SuperDabT/stm32-lidar-scanner/captures/width_test.txt

48,111,313,49,1
46,111,322,49,1
44,111,336,49,1
42,111,345,49,1
40,111,346,49,1
38,111,331,49,1
36,111,325,49,1
34,111,302,49,1
32,111,276,49,1
30,111,270,49,1
28,111,264,49,1
26,111,260,49,1
24,111,254,49,1
22,111,251,49,1
20,111,248,49,1
18,111,245,49,1
16,111,243,49,1
14,111,237,49,1
12,111,232,49,1
10,111,261,49,1
8,111,266,49,1
6,111,259,49,1
4,111,264,49,1
2,111,264,49,1
DET,109,15
0,111,262,49,1
2,111,257,49,1
4,111,263,49,1
6,111,264,49,1
8,111,260,49,1
10,111,261,49,1
12,111,267,49,1
14,111,257,49,1
16,111,234,49,1
18,111,248,49,1
20,111,244,49,1
22,111,246,49,1
24,111,250,49,1
26,111,253,49,1
28,111,258,49,1
30,111,261,49,1
32,111,268,49,1
34,111,275,49,1
36,111,288,49,1
38,111,320,49,1
40,111,331,49,1
42,111,342,49,1
44,111,345,49,1
46,111,340,49,1
48,111,325,49,1
50,111,316,49,1
52,111,307,49,1
54,111,298,49,1
56,111,290,49,1
58,111,285,49,1
60,111,279,49,1
62,111,274,49,1
64,111,268,49,1
66,111,263,49,1
68,111,257,49,1
70,111,254,49,1
72,111,250,49,1
74,111,249,49,1
76,111,244,49,1
78,111,242,49,1
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
DET,23,173,32
0,111,263,49,1
2,111,257,49,1
4,111,264,49,1
6,111,264,49,1
8,111,260,49,1
10,111,262,49,1
12,111,268,49,1
14,111,254,49,1
16,111,235,49,1
18,111,240,49,1
20,111,175,49,1
22,111,173,49,1
24,111,173,49,1
26,111,172,49,1
28,111,178,49,1
30,111,182,49,1
32,111,258,49,1
34,111,274,49,1
36,111,293,49,1
38,111,324,49,1
40,111,330,49,1
42,111,343,49,1
44,111,345,49,1
46,111,337,49,1
48,111,326,49,1
50,111,316,49,1
52,111,305,49,1
54,111,297,49,1
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
122,111,242,49,1
120,111,246,49,1
118,111,34,49,1
116,111,30,49,1
114,111,27,49,1
112,111,22,49,1
110,111,20,49,1
108,111,21,49,1
106,111,21,49,1
104,111,22,49,1
102,111,24,49,1
100,111,30,49,1
98,111,230,49,1
96,111,230,49,1
94,111,229,49,1
92,111,121,49,1
90,111,115,49,1
88,111,115,49,1
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
