SuperDabT/stm32-lidar-scanner/Core/Src/main.c

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
/* Includes ------------------------------------------------------------------*/
#include "main.h"
#include "detect.h"
#include "stm32f4xx_hal.h"
#include "tim.h"
#include "usart.h"
#include "gpio.h"

/* USER CODE BEGIN Includes */
#include <stdint.h>
#include <stdio.h>
#include <stdbool.h>
#include "servo.h"
#include "tfluna.h"
#include "detect.h"
/* USER CODE END Includes */

/* USER CODE BEGIN PD */
#define SCAN_DWELL_MS      50      // Servo settle time before next reading
#define TEMP_TRIP_C        60.0f   // Halt scanning at or above this
#define TEMP_CLEAR_C       55.0f   // Resume scanning at or below this
#define WARN_INTERVAL_MS   1000    // How often to print the halt warning
#define SCAN_TILT 0   /* 1 = tilt raster on, 0 = level-only scanning */


/* USER CODE END PD */


void SystemClock_Config(void);
/* USER CODE BEGIN PFP */
bool elapsed(uint32_t *last, uint32_t interval);
int _write(int file,char *ptr, int len);
/* USER CODE END PFP */

/**
  * @brief  The application entry point.
  * @retval int
  */
int main(void)
{

  /* MCU Configuration--------------------------------------------------------*/

  /* Reset of all peripherals, Initializes the Flash interface and the Systick. */
  HAL_Init();

  /* Configure the system clock */
  SystemClock_Config();

  /* Initialize all configured peripherals */
  MX_GPIO_Init();
  MX_TIM2_Init();
  MX_USART2_UART_Init();
  MX_USART1_UART_Init();
  /* USER CODE BEGIN 2 */
servo_init();
tfluna_init();




/* USER CODE END 2 */

  /* Infinite loop */
  /* USER CODE BEGIN WHILE */
		while (1) {

    /* Static so they survive between iterations. The loop body runs
       thousands of times a second; the timed block inside is what actually
       steps the scan. */
    
    static bool halted=false;
    static float    pan_angle     = 0.0f;
    static float    pan_step      = PAN_STEP_DEG;
    static uint32_t pan_last_move = 0;
    static uint32_t warn_last=0;

    static float tilt_angle = TILT_LEVEL;
    #if SCAN_TILT
    static float tilt_step  = TILT_STEP_DEG;
    #endif

    bool reversed = false;


    /* 50 ms is measured, not chosen. A servo commanded to a new angle is
       still travelling when the next reading arrives, so the reading
       belongs to a position the code has already left. The error shows up
       as a sharp edge landing at different bearings depending on sweep
       direction: 40 ms gives 6 degrees of split, 45 gives 4, 50 gives 2,
       65 gives none. 50 is the fastest interval holding the split within
       one 2-degree step, which is the floor either way. */
    
    /* Two thresholds, not one. The TF-Luna's ceiling is 60 C and it runs
         43-52 in normal operation, so a single threshold would flap on and
         off at the boundary. Trips at 60, clears at 55; between the two it
         holds whatever state it's in. */

    
    if (elapsed(&pan_last_move, SCAN_DWELL_MS)) {
      float temp_c=tfluna_temperature();
      if(temp_c>=TEMP_TRIP_C){
        halted=true;
    }
    if(temp_c<=TEMP_CLEAR_C){
      halted=false;
    }
    
    if (halted){
      if (elapsed(&warn_last, WARN_INTERVAL_MS)){
      printf("WARNING: TF-Luna at %d C, SCANNING HALTED\r\n",
      (int)temp_c);
    }
  }
    else{

        tfluna_reading_t current_reading= tfluna_read();

      
      uint16_t distance=current_reading.distance;
      bool valid=current_reading.valid;
      

        /* Report before commanding. At this point pan_angle is still the
           angle the head has been parked at for the last 50 ms, so the
           reading and the label match. Printing after the move would
           attach each reading to the position it was heading toward
           rather than the one it came from. */
        printf("%d,%d,%d,%d,%d\r\n",
          (int)pan_angle,
          (int)tilt_angle,
          distance,
          (int)temp_c,
          valid);



        if (valid) {
          uint16_t  true_bearing=pan_angle;

        if(pan_step<0){
          true_bearing=pan_angle+PAN_DOWN_CORR_DEG; 
        }

          
          bool run_closed=detect_feed((int)true_bearing, distance,HAL_GetTick());

          if (run_closed) {
            detection_t newest_detection = detect_latest();
            if (newest_detection.found) {
              printf("DET,%d,%d,%u\r\n", (int)newest_detection.bearing,
                     newest_detection.distance, newest_detection.width);
            }
          }
        }
        pan_angle += pan_step;
        servo_write(pan_angle, 'p');

        /* Limit test after the command, so the angle written is always the
           limit itself and never one step past it. */
        if (pan_angle >= PAN_MAX) {
            pan_step = -pan_step;
            reversed = true;
        }
        if (pan_angle <= PAN_MIN) {
            pan_step = -pan_step;
            reversed = true;
        }

        /* Tilt advances once per completed pan sweep, giving stacked
           horizontal rows rather than the diagonal smear you get from
           stepping both axes together. Step stays at 3 degrees: the beam
           is about 2 wide, so a larger step would leave unscanned gaps
           between rows. */
           #if SCAN_TILT
        if (reversed) {
          servo_write(tilt_angle, 't');

          tilt_angle += tilt_step;
          if (tilt_angle >= SCAN_TILT_MAX) {
            tilt_angle = SCAN_TILT_MAX;
            tilt_step = -tilt_step;
          }
          if (tilt_angle <= SCAN_TILT_MIN) {
            tilt_angle = SCAN_TILT_MIN;
            tilt_step = -tilt_step;
          }
        }
        #endif
        if(reversed){
          detect_sweep_end();
          detection_t detections[MAX_OBJECTS];
          uint8_t sus_objects;

          sus_objects=detect_result(detections, MAX_OBJECTS);

          for(uint8_t i=0;i<sus_objects;i++){
            printf("DET,%d,%d,%u\r\n",
            (int)detections[i].bearing,
            detections[i].distance,
            detections[i].width);
          }
        }
    }
  }
	}


            
  

    /* USER CODE END WHILE */
    
}


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
/* USER CODE BEGIN 4 */

/* Non-blocking interval timer. Takes a pointer so each caller keeps its own
   schedule in the same loop — no blocking delays anywhere in normal
   operation. Everything stays uint32_t deliberately: HAL_GetTick wraps
   after about 49 days, and unsigned subtraction wraps with it, so the
   elapsed time stays correct across the rollover. Storing the result in a
   signed type would make the comparison fail permanently. */

bool elapsed(uint32_t *last, uint32_t interval) {
  uint32_t now_ms=HAL_GetTick();
	if (now_ms - *last >= interval) {
		*last = now_ms;
		return true;
	} else
		return false;
}

/* printf retarget. newlib calls _write for stdout, so this puts printf on
   USART2 and the ST-Link virtual COM port. Blocking: a 20-character CSV
   line is about 1.7 ms at 115200, which sits inside the 50 ms budget but
   is real time spent, and it grows if fields are added. */

int _write(int file,char *ptr, int len){
	HAL_UART_Transmit(&huart2,(uint8_t *)ptr,len,5);
	return len;
}
/* USER CODE END 4 */
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
