SuperDabT/stm32-lidar-scanner/Core/Src/detect.c

/* detect.c — finds things in the room that weren't there when it was empty.

   Two phases:
   1. CALIBRATING: the room is empty. Record 3 sweeps, take the middle
      value at each angle. That's the "before photo" (baseline).
   2. WATCHING: compare every new reading to the before photo. A run of
      readings that are much closer than normal is a candidate object.

   Detection only finds candidates. It has no memory between sweeps, so
   it can't tell a person from a moved chair; the tracker decides that. */

#include "detect.h"
#include "servo.h"
#include <stdbool.h>
#include <stdint.h>
#include <math.h>

/* ---- Settings ---------------------------------------------------------- */

/* One slot per angle the head stops at: 0, 2, 4 ... so (range / step) + 1.
   Tied to the servo constants, so changing the step resizes everything. */
#define PAN_SLOTS ((((int)PAN_MAX - (int)PAN_MIN) / (int)PAN_STEP_DEG) + 1)

/* Sweeps recorded during calibration. Must be odd: the median of an even
   count averages the middle two, so one bad reading blends in instead of
   being outvoted. 3 is the smallest count that protects you. */
#define BASELINE_SWEEPS 3

/* How much closer than normal a reading must be to count as "something
   there". Measured: below 15 the sensor's own wobble trips it, above 65
   a person gets missed. 40 is the middle of that band. */
#define MIN_DROP_CM 40

/* Fewest readings in a row before a run is believed. Shorter = glitch. */
#define MIN_RUN_LENGTH 3

/* ---- Calibration memory ------------------------------------------------ */

static uint16_t background[PAN_SLOTS][BASELINE_SWEEPS]; /* scratch pad: 3 raw readings per angle */
static uint16_t baseline[PAN_SLOTS];                    /* finished before photo: 1 per angle */
static uint8_t  sweep_counter = 0;                      /* which calibration column we're filling */
static bool     calibrating   = true;                   /* start by learning the room */

/* ---- The run currently being built --------------------------------------
   Instead of storing every reading in a run, keep just what we need:
   where it started, where it ended, the closest point, and how long.   */

static uint16_t first_bearing;
static uint16_t first_dist;
static uint16_t last_bearing;
static uint16_t last_dist;
static uint16_t min_dist;            /* closest point: ignores the half-on-the-wall edges */
static uint8_t  readings_count = 0;  /* 0 means no run is going */
static uint32_t first_time;
static uint32_t last_time;

/* ---- Finished runs, waiting for main.c to collect them ------------------ */

static detection_t objects[MAX_OBJECTS];
static uint8_t     object_count    = 0;  /* how many stored = index of next free slot */
static uint16_t    dropped_counter = 0;  /* runs lost because all slots were full */

/* ---- Helpers ------------------------------------------------------------ */



/* Middle value of three. Sorts them by swapping, then b is the middle. */
static uint16_t median3(uint16_t a, uint16_t b, uint16_t c) {
  uint16_t temp_val = 0;

  if (a > b) { temp_val = a; a = b; b = temp_val; }
  if (a > c) { temp_val = c; c = a; a = temp_val; }
  if (b > c) { temp_val = c; c = b; b = temp_val; }
  return b;
}




to_xy_t convert_xy (float bearing,uint16_t distance){
  to_xy_t point;

  point.x= distance*cosf((bearing*((float)M_PI/180)));
  point.y= distance*sinf((bearing*((float)M_PI/180)));

  return point;
}

detection_t detect_latest(void){
  if(object_count==0){
    detection_t temporary;
    temporary.found=false;
    return temporary;
  }
  return objects[object_count-1];
}

static bool close_run(void) {
  bool saved=false;
  if (readings_count >= MIN_RUN_LENGTH) {       /* real, not a glitch */
    if (object_count < MAX_OBJECTS) { 
      
      to_xy_t first_point=convert_xy(first_bearing,first_dist);
      to_xy_t last_point=convert_xy(last_bearing,last_dist);        
      
      float dx=last_point.x-first_point.x;
      float dy=last_point.y-first_point.y;

      /* room on the shelf */
      objects[object_count].found    = true;
      objects[object_count].distance = min_dist;
      objects[object_count].width    = (uint16_t)sqrtf((dx*dx)+(dy*dy));      
      objects[object_count].bearing  = (last_bearing + first_bearing) / 2.0f; /* middle */
      objects[object_count].time_stamp_ms=first_time + (last_time-first_time)/2;
      object_count++;
      saved=true;
    } else {
      dropped_counter++;                       /* shelf full, count the loss */
    }
  }
  readings_count = 0;  
  return saved;                         /* no run going anymore */
}



/* ---- Public functions (declared in detect.h) --------------------------- */

/* Start (or restart) learning the room. Room must be empty.
   Call only with the head at PAN_MIN, about to begin a sweep: if
   calibration starts mid-sweep, the first column misses some angles,
   their median comes out 0, and those angles go permanently blind. */
void detect_calibrate(void) {
  sweep_counter = 0;
  calibrating = true;
  object_count=0;
  readings_count=0;
}

/* Called by main.c once per reading, every 50 ms. */
bool detect_feed(uint16_t bearing, uint16_t distance,uint32_t time_ms) {
  /* Turn the angle into a shelf slot: 0 → 0, 2 → 1, 4 → 2 ... */
  uint16_t slot = (uint16_t)((bearing - PAN_MIN) / PAN_STEP_DEG);
  if (slot >= PAN_SLOTS) {
    return false;                                     /* off the end: reject, don't corrupt memory */
  }

  if (calibrating) {
    /* Learning: write this reading into the current sweep's column. */
    if (sweep_counter >= BASELINE_SWEEPS) {
      return false;
    }
    background[slot][sweep_counter] = distance;

  } else {
    /* Watching: is this reading a lot closer than the empty room?
       (Written as "distance + 40 < baseline" rather than "distance 
       baseline - 40", because both are unsigned: a baseline under 40
       would wrap around to a huge number.) */
    if (distance + MIN_DROP_CM < baseline[slot]) {
      /* Close: the run grows. */
      if (readings_count == 0) {                /* first reading of a new run */
        first_bearing = bearing;
        first_dist    = distance;
        min_dist      = distance;
        first_time    =time_ms;
      }
      last_bearing = bearing;                   /* always the most recent */
      last_dist    = distance;
      last_time    =time_ms;
      if (distance < min_dist) {
        min_dist = distance;                    /* keep the closest */
      }
      readings_count++;

    } else {
      /* Not close: whatever run was going just ended. */
      bool valid= close_run();
      return valid;
    }
  }
  return false;
}

/* Called by main.c when the head turns around at either end. */
void detect_sweep_end(void) {
  if (calibrating) {
    /* One more column filled. After the last one, squash each angle's
       three readings into one number and switch to watching. */
    sweep_counter++;
    if (sweep_counter == BASELINE_SWEEPS) {
      for (uint8_t i = 0; i < PAN_SLOTS; i++) {
        baseline[i] = median3(background[i][0], background[i][1], background[i][2]);
      }
      calibrating = false;
    }
  }
  close_run();
}

uint8_t detect_result(detection_t detection_array[], uint8_t max_slots){
  uint8_t to_copy;

  to_copy=object_count;
  if(to_copy>max_slots){ to_copy=max_slots;}

  for(uint8_t i=0;i<to_copy;i++){
    detection_array[i]=objects[i];
  }
  object_count=0;

  return to_copy;
}
