SuperDabT/stm32-lidar-scanner/(commit log)

2026-09-06 added a new function servo_home() for smoother startup
2026-09-06 Split the servo code into servo.c/ servo.h
2026-09-06 TF-Luna driver: interrupt-driven UART, frame parser, distance/validity/temperature accessors
2026-09-07 Update README with photos and current project state
2026-09-07 Guard against garbled serial lines in scanner_plot.py
    A UART glitch that corrupts a field's digits (right field count, bad
    content) previously raised an unhandled ValueError and crashed the
    whole live plot. Now that line is just skipped.
    [scanner_plot.py]
2026-09-07 Fix UART error recovery, mark ISR state volatile, improve plotter
    [scanner_plot.py, tfluna.c]
2026-09-08 Extend scanner_plot.py radial range to 400
    Readings past 300 were landing outside the plotted disc and getting
    clipped. Widening the radial axis so the longer returns stay visible.
    Claude-Session: https://claude.ai/code/session_012mnMaa157uQ9seyVkrUntT
2026-09-10 Remove ST-specific compiler flag, drop leaf HAL include
    -fcyclomatic-complexity is not recognised by stock arm-none-eabi-gcc,
    which broke the build on Linux. Also removed the direct
    stm32f4xx_hal_uart.h include from tfluna.c; main.h already pulls it in.
    [tfluna.c]
2026-09-10 Name servo timing constants, document pan range headroom
    Replace magic numbers in servo_write with SERVO_MIN_US, SERVO_MAX_US
    and SERVO_RANGE_DEG, separating the servo's fixed characteristics from
    the travel limits we choose. Pan probing showed usable movement to
    around 210 degrees, but past 180 is extrapolation beyond the specified
    pulse range, so PAN_MAX stays at 180 with a note explaining why.
    [servo.c, servo.h]
2026-09-10 Calibrate servo pulse range, fix reading-to-angle timing
    Measured travel: 1000-2000us gave only ~130 degrees on these units;
    500-2500us gives a true 180. Verified linear at the midpoint.
    Reordered the scan loop to print the current angle before commanding
    the next move, so each reading is labelled with the position it was
    taken at. Also removes the one-step overshoot past PAN_MAX. Dwell
    raised to 50ms, measured as the fastest interval where a sharp edge
    lands within one step on both sweep directions -- 40ms gives 6 degrees
    of split, 65ms gives none.
    [main.c, servo.h]
2026-09-11 Calibrate servo ranges, fix reading-to-angle timing
    Pan: 1000-2000us gave only ~130 degrees of travel on these units.
    500-2500us gives a true 180. Verified linear at the midpoint and
    zero offset by finding the perpendicular to a flat surface.
    Tilt: geometry was documented backwards. 115 is level, lower numbers
    point up, higher point down. Range set to 80-115 -- level and above
    only, since a downward beam mostly returns floor. Mechanical headroom
    tested to 150 but unused.
    Scan loop now prints the current angle before commanding the next
    move, so each reading is labelled with the position it was taken at.
    This fixes a 16-degree bearing split between sweep directions and
    removes the one-step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
    [main.c, servo.c, servo.h]
2026-09-11 Update README with calibration results and measured timings
2026-09-11 Add replay mode to the visualiser
    Pass a CSV on the command line and the plot reads from the file
    instead of the serial port, so detection work no longer needs the
    board attached. Loops at the end of the file; space pauses. Guards
    the artist update against an empty point list, which set_alpha
    rejects.
    [scanner_plot.py]
2026-09-11 Add PID controller
    Velocity-form PID for the pan axis. Derivative acts on the measurement
    rather than the error, so a setpoint jump from detection doesn't
    produce a one-cycle spike. Both the integral and the output are
    clamped, since clamping only the output lets the integral keep
    winding while the servo sits at a limit. Ki is folded into the
    accumulation so changing gains mid-run doesn't rescale what's
    already banked.
    [pid.c, pid.h]
2026-09-11 Document the drivers and the controller
    Comments explain the reasoning behind decisions that aren't obvious
    from the code: why the parser hunts two header bytes, why the shared
    state is volatile, why the error callback re-arms without feeding the
    parser, why the derivative acts on the measurement, and why both the
    integral and the output are clamped.
    Also reindents tfluna_feed so the state machine's structure is visible,
    and groups the accessors together.
    [pid.c, servo.c, tfluna.c]
2026-09-11 Document the scan loop
    Records why the 50 ms dwell is what it is, why the reading is printed
    before the next move is commanded, why the limit test follows the
    command rather than preceding it, and why the tilt step stays at 3
    degrees. Also notes the unsigned-wraparound reasoning in elapsed and
    the cost of the blocking printf.
2026-09-11 Add off-target test harness for the PID
    Simulates the velocity-form plant on the host so the controller can be
    exercised without hardware: head position accumulates from the returned
    slew rate at the same 50 ms interval the firmware uses. Confirms P-only
    converges asymptotically, PI overshoots by about 4 degrees regardless of
    Kd, and P+D alone reaches the setpoint without overshoot.
2026-09-11 Add TF-Luna over-temperature guard
    Halts scanning if the sensor reaches 60 C and resumes below 55, with
    the gap preventing it flapping at the boundary. While halted the head
    freezes where it is and a warning prints once a second instead of CSV,
    so the stream shows the board is alive and why it stopped rather than
    just going quiet.
    [main.c]
2026-09-12 Clamp tilt angle to its limits before reversing
    115 down to 80 in 3-degree steps lands on 79, which servo_write rejects,
    so the CSV recorded a row the head never reached. Clamping works for any
    step size rather than relying on the range dividing evenly.
    [main.c]
2026-09-13 "calibrated tilt levels, found out that 111.3 is level and applied that into the code"
2026-09-13 "Address review findings: named constants, bounded UART timeout, plot range
    - elapsed(): single HAL_GetTick() call instead of two
    - Removed redundant stm32f4xx.h include (already pulled in via main.h)
    - _write(): bounded 5ms UART timeout instead of HAL_MAX_DELAY
    - Named magic numbers in main.c (SCAN_DWELL_MS, TEMP_TRIP_C, TEMP_CLEAR_C, WARN_INTERVAL_MS)
    - scanner_plot.py: named RMAX_CM=500 instead of a bare set_ylim(0, 400)
    - Added MIT LICENSE
    Deferred: [1] error-callback re-arm return value, [2] torn
    distance/valid pair across ISR boundary, [6] silent servo_write
    rejection, [8] telemetry framing, [9] serial read stall — all need
    a design decision, not just a naming fix."
    [main.c, scanner_plot.py]
2026-09-13 "Cache temp per tick, name step constants, fix stale tilt comments, drop dead PID test
    - main.c: sample tfluna_temperature() once per tick instead of 3x
    - main.c: PAN_STEP_DEG/TILT_STEP_DEG replace bare 2.0f/-3.0f
    - servo.h: TILT_LEVEL corrected to 111.0f (was false-precision 111.3f);
    comments on TILT_MAX/TILT_LEVEL were swapped, now match their values
    - servo.c: removed stale inline comment duplicating TILT_LEVEL's own doc
    - Removed tests/test_pid.c — PID theory already confirmed via it,
    keeping a dead non-asserting test around was worse than deleting it"
2026-09-15 Add detection captures: empty room baseline, two static positions, two walking
    [empty_room.csv, pan_offset.csv, person_15.csv, person_95.csv, person_walking.csv, person_walking_slow.csv]
2026-09-15 Pan offset: servo_write takes true bearings, 90 is straight ahead
    PAN_OFFSET_DEG 15 — command 105 points along the base's forward axis,
    measured with a straightedge against the square base. Scan loop, CSV,
    and downstream detection now all speak true bearings.
    Also: TILT_LEVEL corrected to 111.0 (111.3 was false precision — the
    knee was only bracketed to whole command units), TILT_MAX/TILT_LEVEL
    comments swapped back onto the values they describe, PAN_STEP_DEG and
    TILT_STEP_DEG named, temperature sampled once per tick.
    [main.c, servo.c, servo.h]
2026-09-18 Add Python detection prototype
    Background subtraction against an empty-room baseline, run-finding over
    consecutive close readings, and a person-sized width filter measured in
    cm via a polar-to-Cartesian transform.
    Validated against the captures: finds the target in 26/26 sweeps at
    bearing 20 and 23/24 at bearing 98, with zero false positives across 24
    empty-room sweeps. min_drop_cm=40 comes from sweeping the threshold from
    5 to 100 — below 15 the sensor's own noise trips it, above 65 the weaker
    signal is missed, so 40 is the middle of the usable band.
    Authorship: background_profile, detect, object_width, keep_person_sized
    and to_xy written by me; the CSV loader, sweep splitter and evalua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
    [detect.py, scan_data.py, scanner_plot.py]
2026-09-18 Start C port of detection; PAN_MAX back to 165
    detect.h defines the module contract: detection_t plus calibrate, feed
    and result. Everything else stays private in detect.c — the background
    array, the sweep counter and median3.
    Baseline is 3 sweeps: an even count makes the median an average of the
    middle two, so a bad reading blends in rather than being outvoted.
    PAN_SLOTS derives from PAN_MIN/PAN_MAX/PAN_STEP_DEG so the array can't
    disagree with the sweep.
    PAN_MAX returns to 165 after heat at the servo base — true 180 maps to
    command 195, past the calibrated 2500us ceiling, so the head reaches its
    stop while still being commanded further.
2026-09-18 Move PAN_STEP_DEG to servo.h; add median3 and detect_calibrate
    PAN_STEP_DEG lived in main.c's private defines, but detect.c needs it to
    size the background array and can't include main.c. It describes the
    sweep PAN_MIN/PAN_MAX bound, so servo.h is where it belongs.
    median3 sorts three values by swapping and returns the middle one —
    verified exhaustively off-target across every combination 0-40 plus
    duplicates and edges. detect_calibrate resets the sweep counter and
    re-enters learning mode; the background array is deliberately left
    alone, since calibrating gates every read of it.
    [detect.c, main.c, servo.h]
2026-09-18 Detection: calibration path
    detect_sweep_end added to the interface — main.c reports the end of each
    sweep from its existing reversed flag rather than detection re-deriving
    it from the bearings, so the rule for 'sweep ended' lives in one place.
    detect_feed maps bearing to slot via PAN_MIN/PAN_STEP_DEG and rejects
    out-of-range slots rather than clamping, matching servo_write. Three raw
    sweeps land in background[][]; detect_sweep_end squashes each row to its
    median in baseline[] and leaves calibrating.
    [detect.c, detect.h]
2026-09-21 Detection: watching branch of detect_feed
    Runs are tracked as six scalars rather than a buffer of readings —
    first and last bearing/distance, the running minimum, and a count.
    Evenly spaced bearings mean the centroid equals the midpoint of first
    and last, and the width only ever needed the two endpoints, so nothing
    is lost and there is no overflow case to handle.
    Range is the minimum rather than the mean: the readings at a cluster's
    edges are the beam half on the target and half on the wall behind, so
    averaging drags the answer toward the wall. On person_15 the run reads
    229, 203, 170, 170, 170, 172, 174, 230 — mean 190, which nothing in the
    room is; minimum 170, which is where the targ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
2026-09-24 Detection: store finished runs as candidates
    The detector no longer picks a single winner. It has no memory across
    sweeps, so it can't tell a person from a moved chair of the same width;
    that needs motion, which only the tracker sees. Every run of at least
    three readings is stored in objects[] (up to MAX_OBJECTS) for the
    tracker to choose from. Runs past capacity are counted in
    dropped_counter rather than silently lost.
    Bearing is the midpoint of the first and last reading; distance is the
    run's minimum. Width stays 0 until to_xy is ported.
    [detect.h]
2026-09-24 Add detect.c changes missed from previous commit
    [detect.c]
2026-09-24 Detection: finish C port, verified against captures
    close_run() closes a run from both places a run can end: a not-close
    reading in detect_feed, and a sweep reversal in detect_sweep_end.
    detect_result copies at most max_slots candidates into the caller's
    array, returns the count, and empties the shelf for the next sweep.
    detect_calibrate now also clears the shelf and any half-built run.
    Verified on the host by replaying the recorded captures through this
    file: 26/26 at bearing 20.0, 23/24 at bearing 98.0, zero false alarms
    across 21 held-out empty-room sweeps — identical to the Python
    prototype.
    The replay also found a bug: calibration starting mid-sweep leaves
    columns unwritten, the med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
    [detect.c]
2026-09-24 Detection runs live on the board
    Wire detection into the main loop. Valid readings are fed to
    detect_feed at the report-before-command point, where bearing and
    reading are guaranteed to match; invalid ones are still printed but
    never reach the detector, since the sensor reports 0 cm for them. On
    each reversal, detect_sweep_end closes any open run and detect_result
    hands back candidates, printed as DET,bearing,distance. Tilt is fixed
    at level so every sweep matches the baseline slice. A 10 s startup
    delay gives time to leave the room before calibration (temporary,
    until the pause-and-home sequence exists).
    Also: MAX_OBJECTS moves to detect.h, since main.c now sizes its
    array from it; detect.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
    [first_live.csv, live_15.csv]
2026-09-24 README: trim build notes to lessons learned
    Drop the dead-servo and power-supply notes; keep the three lessons
    about finding invisible bugs.
    Claude-Session: https://claude.ai/code/session_015uXEZn3YEas1UUfDztgdNf
2026-09-25 README: add the calibration math and experiments
    Derivations and raw data for the timer, pulse range, pan offset, travel
    limit, tilt level (floor hit and wall knee), dwell time, detection
    threshold, width and the walking-person aliasing, with the math in
    LaTeX. Fixes the edge-reading average (184, not 190) and the
    floor-range table.
    Written by Claude; the experiments and measurements were done by me.
2026-09-26 Detector reports object width in cm; bearing-20 test widths 31-56 cm
2026-09-26 Captures: sweep-direction bearing test (down reads ~3 deg low) and 65 ms dwell test
2026-09-27 Correct down-sweep bearing by +3 deg; gap 3.0 -> 0.8 deg, fixes #1
    [main.c, servo.h]
2026-09-27 Add SCAN_TILT flag, remove startup delay, fix SCAN_TILT_MAX comment; fixes #5, fixes #6
    [main.c, servo.h]
2026-09-27 Add tfluna_read(): distance and valid copied together with interrupts paused; fixes #4
    [main.c, tfluna.c, tfluna.h]
2026-09-27 Reject readings with amp at or above 32768 (ambient overexposure); fixes #3
    [tfluna.c]
2026-10-01 Start track.c: tracker state enum, track_t, survey state (width filter, first sighting)
2026-10-01 track.c: look history as 4-bit mask, push_look and count_hits helpers
2026-10-05 Fix typo in count_hits so track.c compiles
    [track.c]
2026-10-06 Radar plot: draw DET detections as red blips
    Parse DET lines (bearing, distance, width) before the 5-field check,
    keep them for 4.5 s like scan points, and draw them on their own
    glow/core layers. Drawing moved into draw_layer() so both layers share
    one code path; time is read with [-1] so it works for both tuple shapes.
    Old entries are pruned before drawing so alpha never goes negative.
2026-10-06 track.c: remove stray double semicolon
2026-10-06 Timestamp each detection at the middle of its run
    detect_feed now takes the time from main.c (HAL_GetTick), so detect.c
    stays HAL-free and can be compiled on a PC for replay tests. close_run
    stamps each detection with the midpoint of its first and last reading,
    matching how bearing is computed. Midpoint uses first + (last-first)/2
    so it can't overflow near the uint32 limit.
2026-10-06 Report detections as their run closes, with timestamps
    detect_feed takes the time from main.c (detect.c stays HAL-free) and
    returns true when a run just became a detection. close_run stamps each
    detection with the overflow-safe midpoint of its first and last reading
    and always resets the run. New detect_latest() returns the newest
    detection (found=false if none); main.c prints its DET line immediately.
    Known leftover: the sweep-end DET printf still runs, so each detection
    is printed twice.
    [detect.c, detect.h, main.c]
